ArcturusLev/Development-Of-Seismic-Data-Acquisition-System-Based-On-ESP32-With-LoRa-Communication/docs/images/diagram_workflow.png

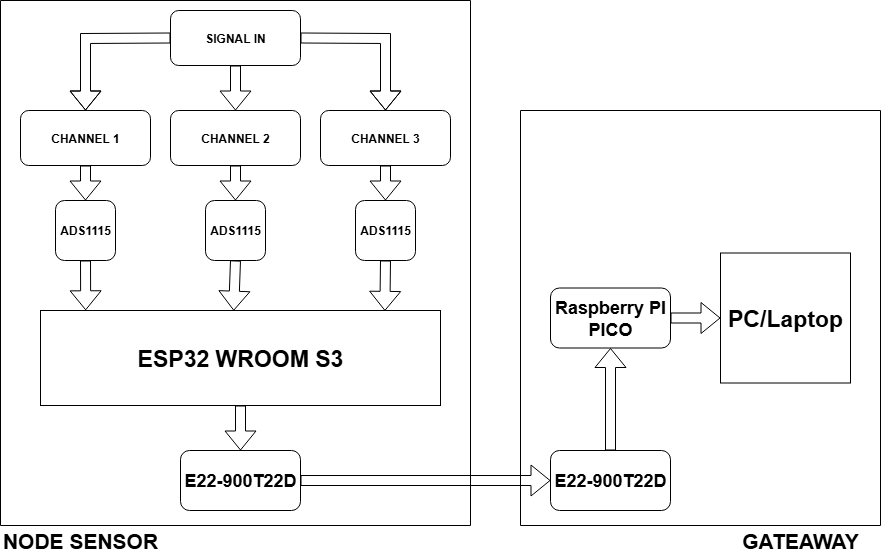
docs/images/diagram_workflow.png
