ArcturusLev/Development-Of-Seismic-Data-Acquisition-System-Based-On-ESP32-With-LoRa-Communication/(list of files, drawings)

Other design files:
pcb_design/ESP32_Wroom.eprj
