ArcturusLev/Development-Of-Seismic-Data-Acquisition-System-Based-On-ESP32-With-LoRa-Communication/(notices)

Notices in the files:
README.md:
License: MIT
